jasoncharlesfry/Model-Train-Controller/Model-Train-Controller.sch

## EAGLE design Model-Train-Controller.sch (2021-08-11)

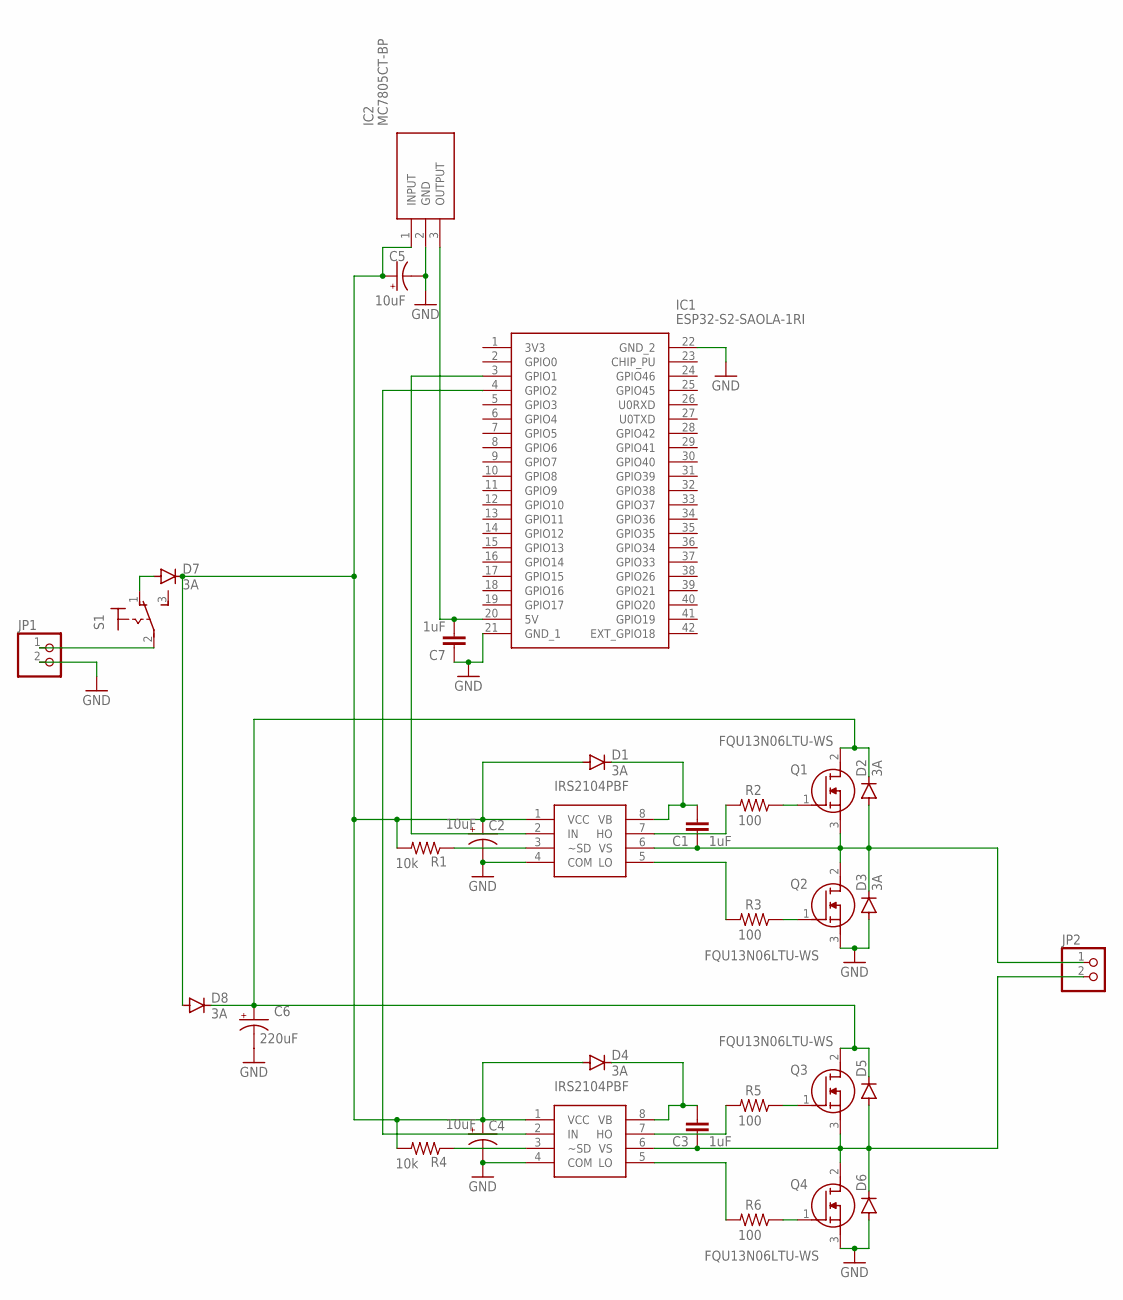
[picture p1: schematic Model-Train-Controller.sch]

Parts:
C1, C3, C7: 1uF; C025-030X050
C2, C4, C5: 10uF; E2-5
C6: 220uF; E2-5
D1, D2, D3, D4, D7, D8: 3A; DO201-15
D5, D6: DIODE-DO201-15; DO201-15
IC1: ESP32-S2-SAOLA-1RI; ESP32S2SAOLA1RI
IC2: MC7805CT-BP; TO254P482X1016X2325-3P
JP1, JP2: PINHD-1X2; 1X02
Q1, Q2, Q3, Q4: FQU13N06LTU-WS; TO229P250X658X985-3P
R1, R4: 10k; 0204/5
R2, R3, R5, R6: 100; 0204/5
S1: 320-916
U$1, U$2: IRS2104PBF; DIL08

Connections:
5V: C7.2, IC1.20 (5V), IC2.3 (OUTPUT)
GND: C2.-, C4.-, C5.-, C6.-, C7.1, D3.A, D6.A, IC1.21 (GND_1), IC1.22 (GND_2), IC2.2 (GND), JP1.2, Q2.3 (S), Q4.3 (S), U$1.4 (COM), U$2.4 (COM)
GPIO1: IC1.3 (GPIO1), U$1.2 (IN)
GPIO2: IC1.4 (GPIO2), U$2.2 (IN)
HO1: R2.2, U$1.7 (HO)
HO2: R5.2, U$2.7 (HO)
LO1: R3.2, U$1.5 (LO)
LO2: R6.2, U$2.5 (LO)
VB1: C1.2, D1.C, U$1.8 (VB)
VB2: C3.2, D4.C, U$2.8 (VB)
VCC: C2.+, C4.+, C5.+, D1.A, D4.A, D7.C, D8.A, IC2.1 (INPUT), R1.2, R4.2, U$1.1 (VCC), U$2.1 (VCC)
VGATE1: Q1.1 (G), R2.1
VGATE2: Q2.1 (G), R3.1
VGATE3: Q3.1 (G), R5.1
VGATE4: Q4.1 (G), R6.1
VIN: JP1.1, S1.2
VLOAD: C6.+, D2.C, D5.C, D8.C, Q1.2 (D), Q3.2 (D)
VS1: C1.1, D2.A, D3.C, JP2.1, Q1.3 (S), Q2.2 (D), U$1.6 (VS)
VS2: C3.1, D5.A, D6.C, JP2.2, Q3.3 (S), Q4.2 (D), U$2.6 (VS)
VSWITCH: D7.A, S1.1 (O)
~SD1: R1.1, U$1.3 (~SD)
~SD2: R4.1, U$2.3 (~SD)
